ripper121/Keyboard/Pr0board_Lite/Firmware/Pr0Board_Led_Test/Button_Mapping.PNG

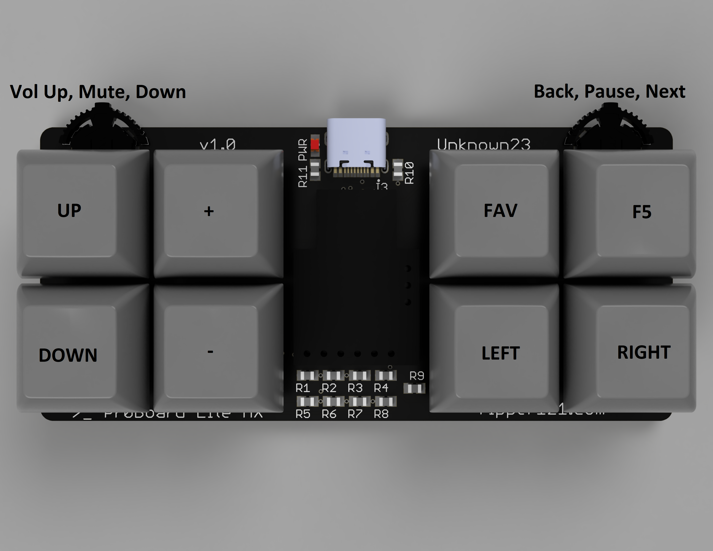
Pr0board_Lite/Firmware/Pr0Board_Led_Test/Button_Mapping.PNG
