ripper121/Keyboard/Pr0Board/Firmware/Bootloader/fuses.png

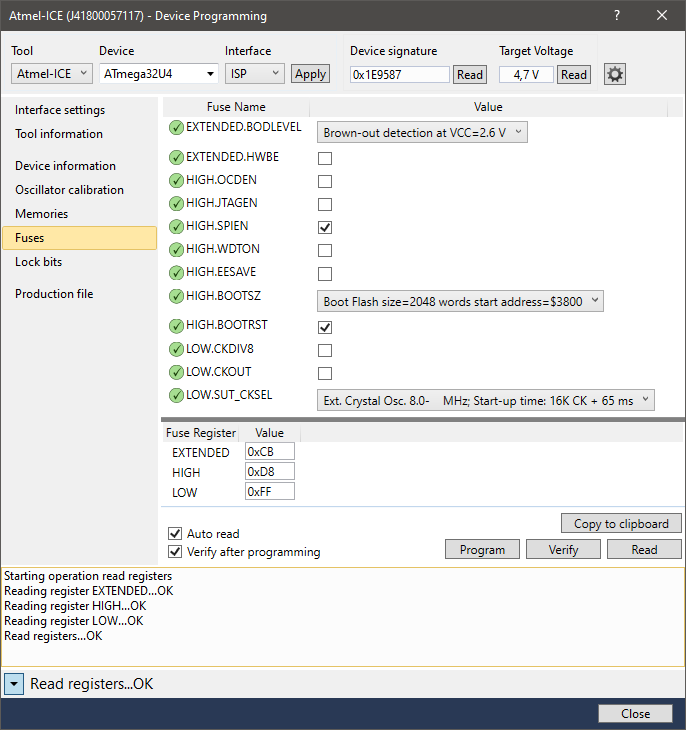
Pr0Board/Firmware/Bootloader/fuses.png
