ripper121/Keyboard/Pr0Board/Hardware/DickButt.jpg

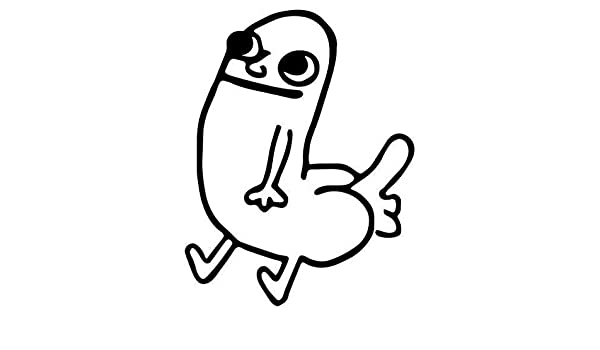
Pr0Board/Hardware/DickButt.jpg
