ripper121/Keyboard/Pr0board_Lite/Firmware/bootloader/fuses.png

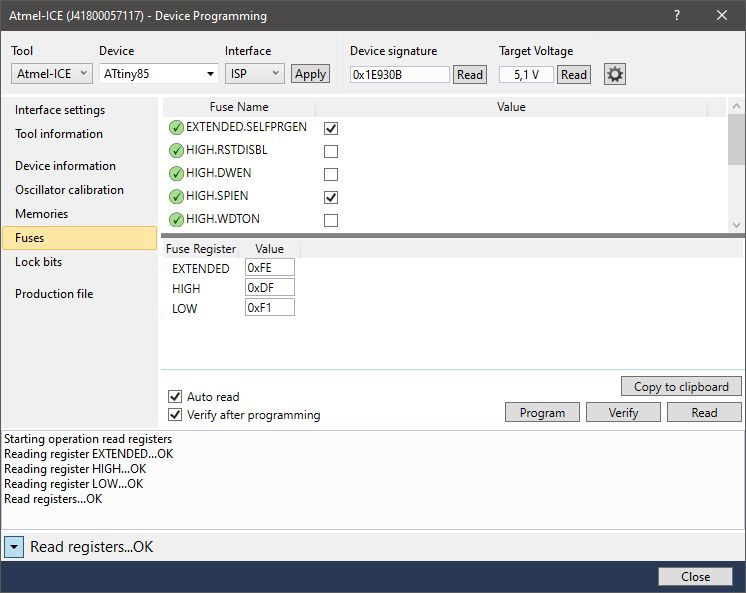
Pr0board_Lite/Firmware/bootloader/fuses.png
