ripper121/Keyboard/Pr0board_Lite/Hardware/render/9a6030ba-e6ec-4932-b883-8665d415793d.PNG

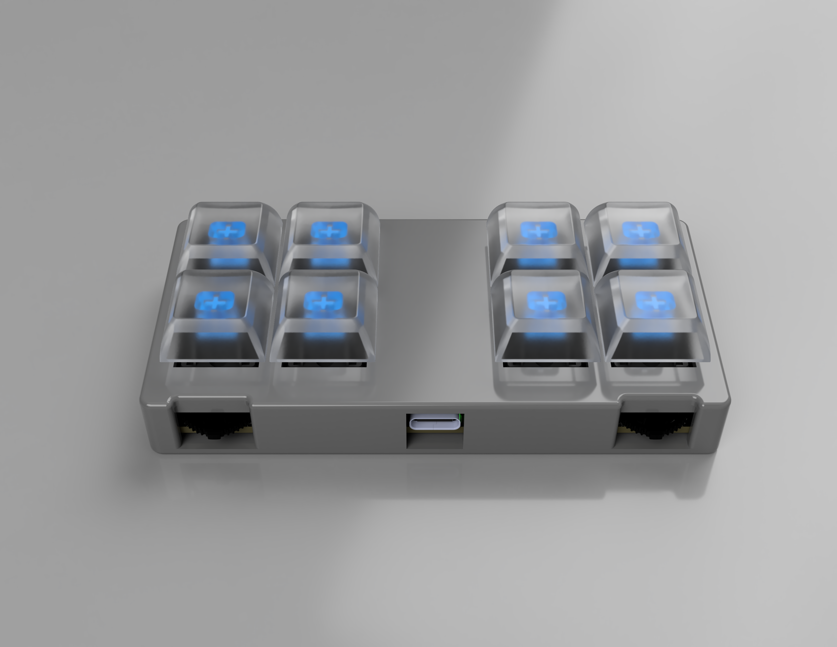
Pr0board_Lite/Hardware/render/9a6030ba-e6ec-4932-b883-8665d415793d.PNG
