ripper121/Keyboard/Pr0board_Lite/Hardware/render/63531ed1-c803-45b3-83f2-83a99b696628.PNG

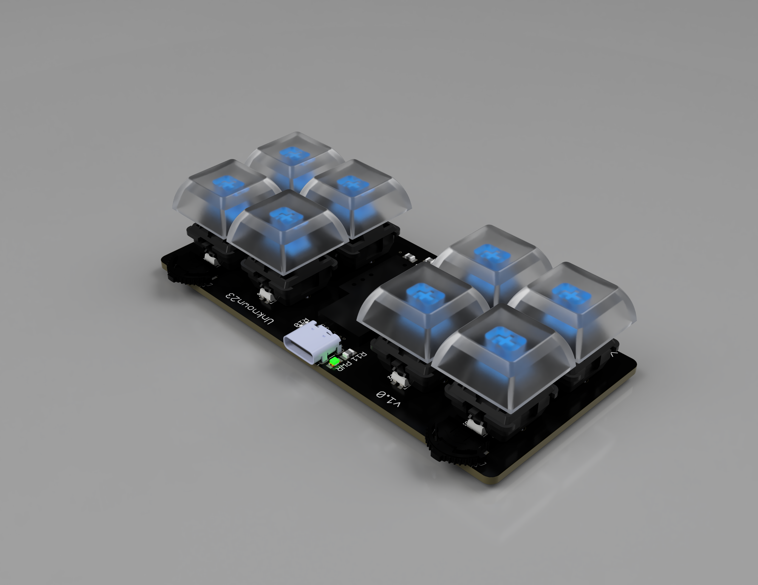
Pr0board_Lite/Hardware/render/63531ed1-c803-45b3-83f2-83a99b696628.PNG
