ripper121/Keyboard/Pr0board_Lite/Hardware/render/b3451999-1874-4866-8d40-73a651b3b092.PNG

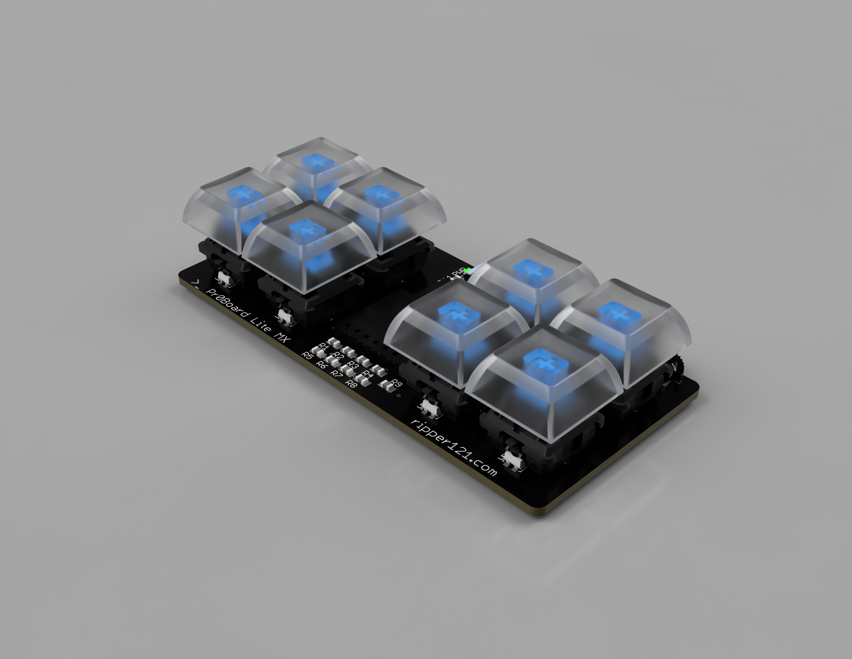
Pr0board_Lite/Hardware/render/b3451999-1874-4866-8d40-73a651b3b092.PNG
