ripper121/Keyboard/Pr0board_Lite/Hardware/render/Pr0board_Lite_MX_2021-May-11_08-17-31AM-000_CustomizedView18568659747.png

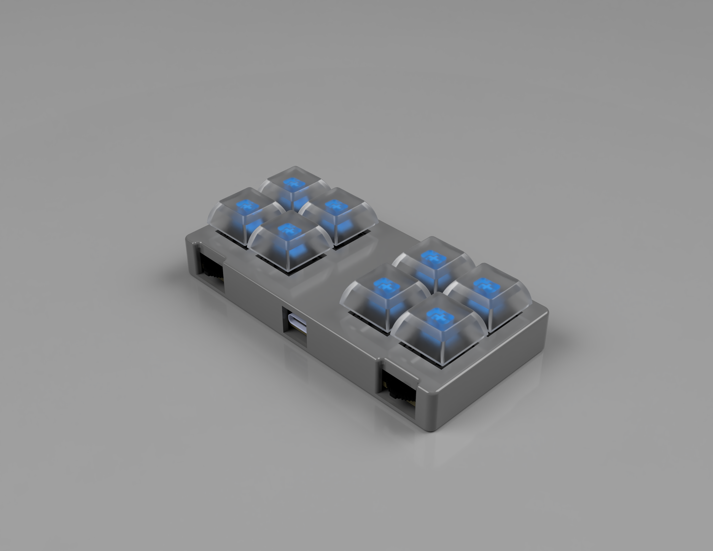
Pr0board_Lite/Hardware/render/Pr0board_Lite_MX_2021-May-11_08-17-31AM-000_CustomizedView18568659747.png
