ripper121/Keyboard/Pr0board_Lite/Hardware/render/Pr0board_Lite_MX_2021-May-11_08-21-41AM-000_CustomizedView15612525975.png

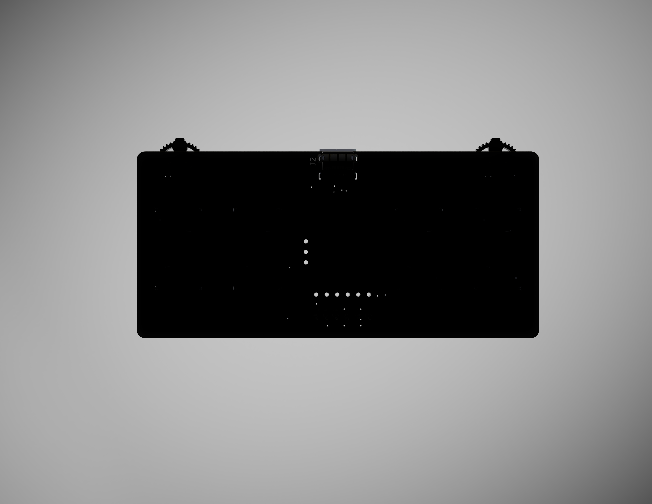
Pr0board_Lite/Hardware/render/Pr0board_Lite_MX_2021-May-11_08-21-41AM-000_CustomizedView15612525975.png
