ripper121/Keyboard/Pr0board_Lite/Hardware/render/Pr0board_Lite_MX_2021-May-11_08-22-08AM-000_CustomizedView36498695861.png

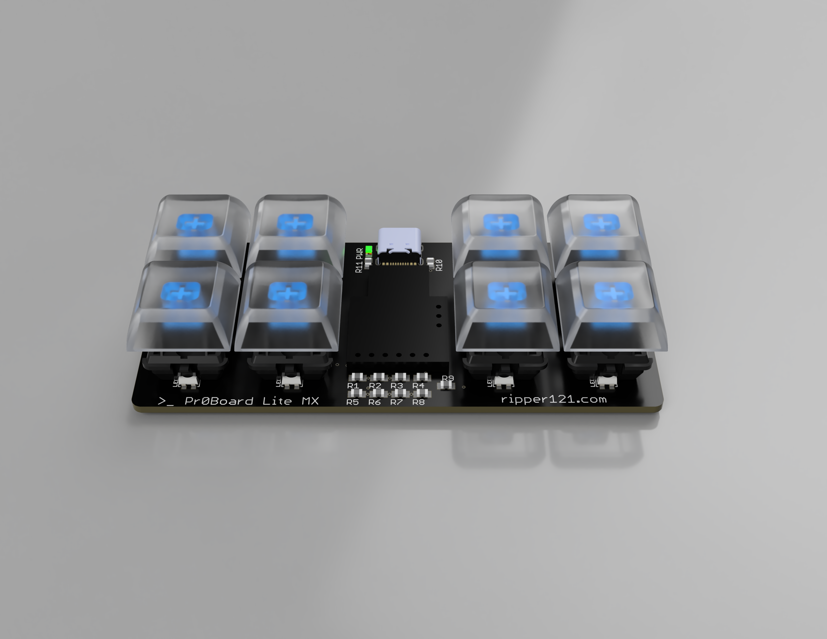
Pr0board_Lite/Hardware/render/Pr0board_Lite_MX_2021-May-11_08-22-08AM-000_CustomizedView36498695861.png
