ripper121/Keyboard/Pr0board_Lite/Hardware/eagle/3d/asm_mx_asm_PCB.stp

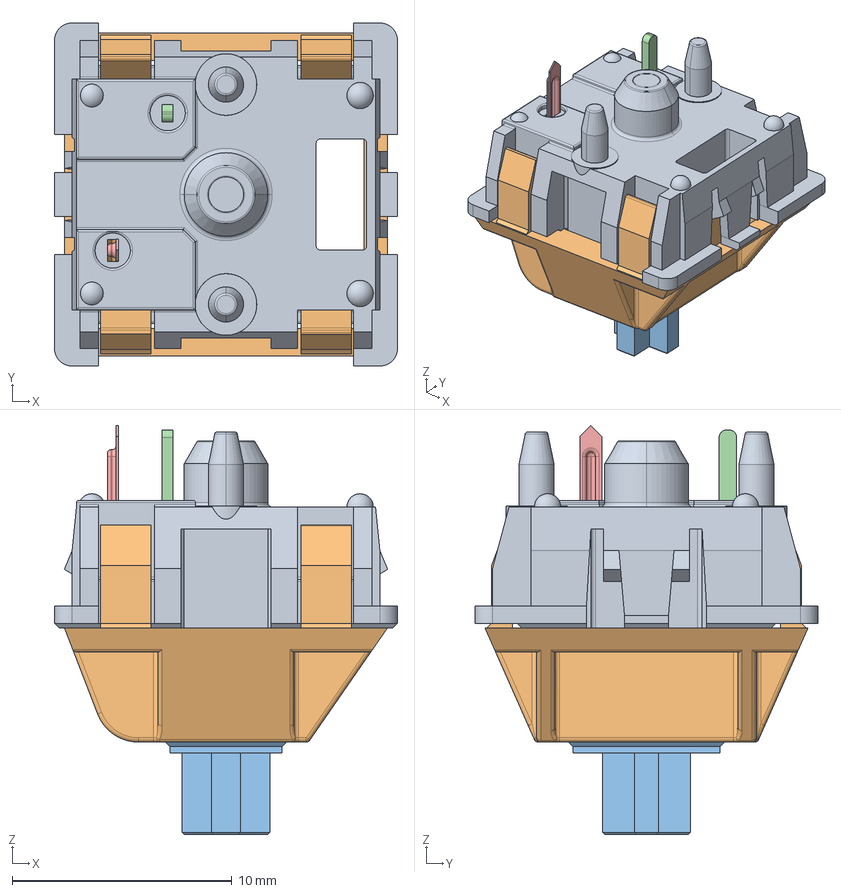
[picture p12: CAD file, 2021-05-19]
Pr0board_Lite/Hardware/eagle/3d/asm_mx_asm_PCB.stp
15.6 x 15.6 x 18.6 mm
MX_DOWN
MX_UP
UP_MX
MX_PIN
MX_SPRING
MX_CLICK
