ripper121/Keyboard/Pr0board_Lite/Hardware/3d/EnclosureTop.stl

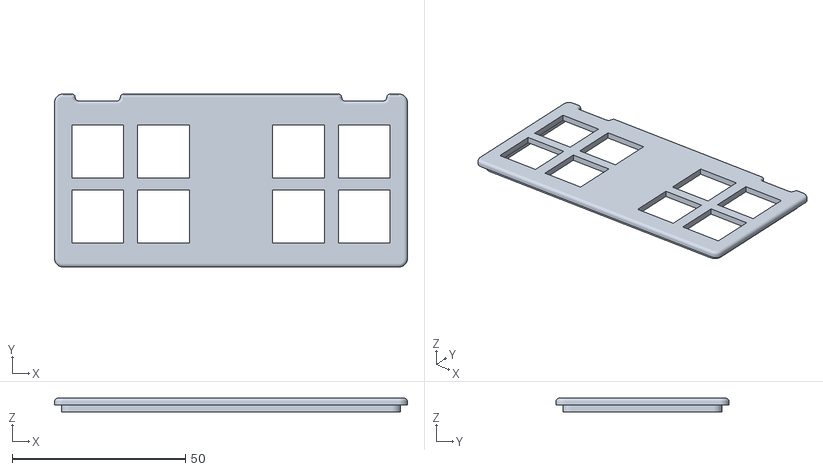
[picture p13: CAD file, 2021-05-19]
Pr0board_Lite/Hardware/3d/EnclosureTop.stl
102.0 x 50.0 x 4.00
