ripper121/Keyboard/Pr0board_Lite/Hardware/3d/EnclosureBottom.stl

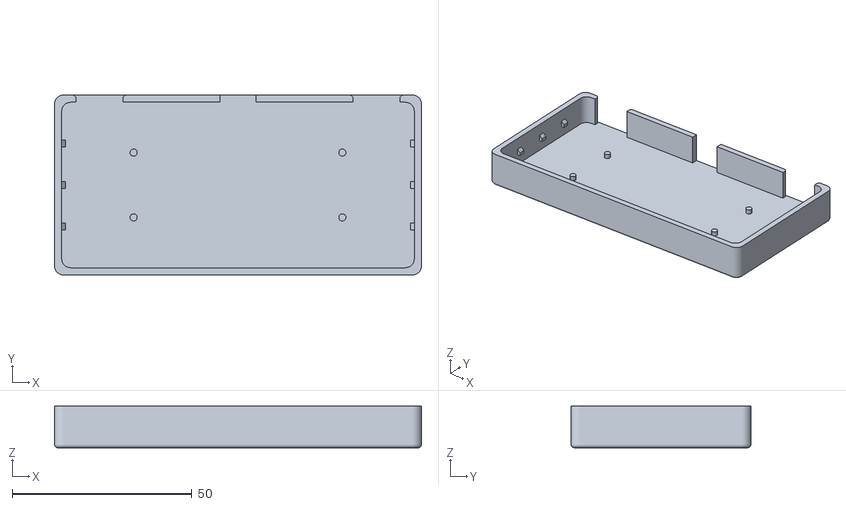
[picture p14: CAD file, 2021-05-19]
Pr0board_Lite/Hardware/3d/EnclosureBottom.stl
102.0 x 50.0 x 11.6
