ripper121/Keyboard/Pr0board_Lite/Hardware/eagle/3d/2-1437565-9.stp

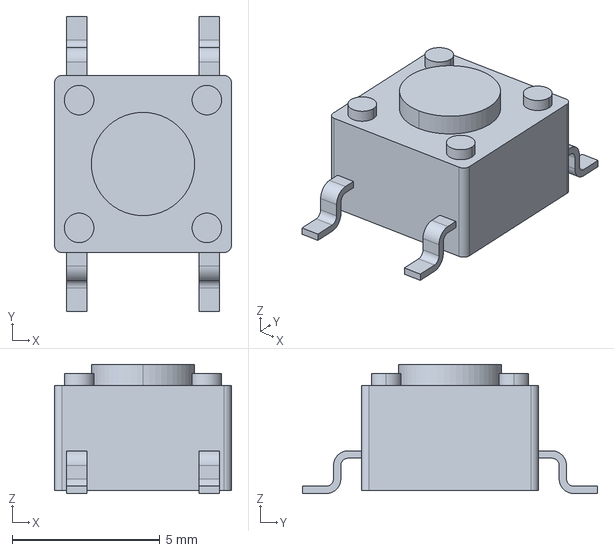
[picture p15: CAD file, 2021-05-19]
Pr0board_Lite/Hardware/eagle/3d/2-1437565-9.stp
6.00 x 10.0 x 4.38 mm
