ripper121/Keyboard/Pr0board_Lite/Hardware/eagle/3d/DigiSpark ATtiny85.STEP

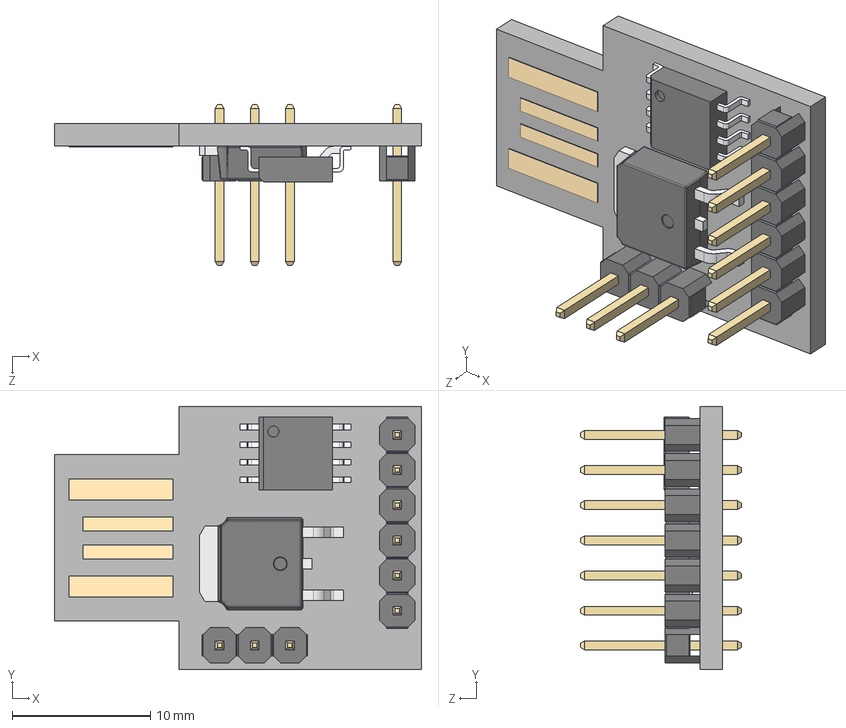
[picture p16: CAD file, 2021-05-19]
Pr0board_Lite/Hardware/eagle/3d/DigiSpark ATtiny85.STEP
26.5 x 19.0 x 11.6 mm
Digispark - Board simple
TO-252AA-IRF
8S2 EIAJ SOIC - ATtiny85 20SU_Valor predeterminado
DS1021-1x3SF11
DS1021-1x6SF11
