ripper121/Keyboard/Pr0board_Lite/Hardware/eagle/3d/TYPE-C-31-M-12--3DModel-STEP-56544.STEP

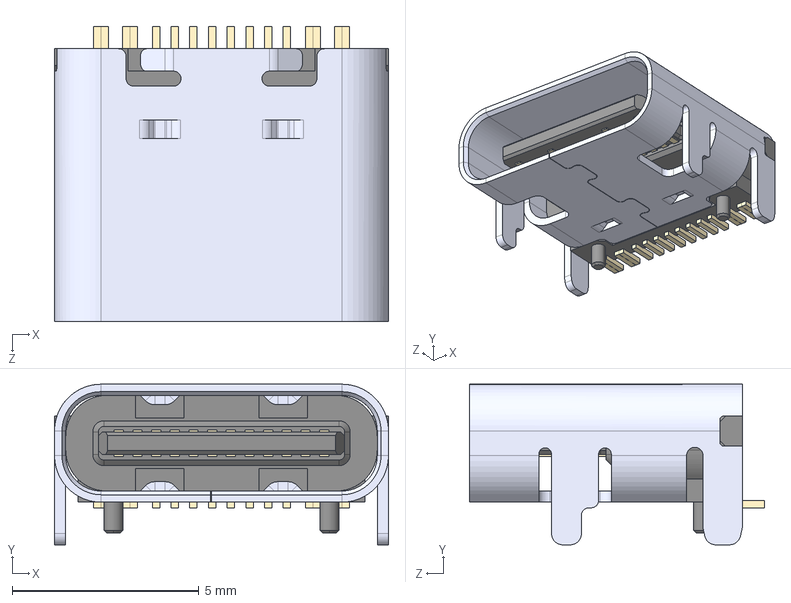
[picture p17: CAD file, 2021-05-19]
Pr0board_Lite/Hardware/eagle/3d/TYPE-C-31-M-12--3DModel-STEP-56544.STEP
8.94 x 4.30 x 7.90 mm
