ripper121/Keyboard/Pr0board_Lite/Hardware/eagle/3d/ts-1187a-x-g-x.stp

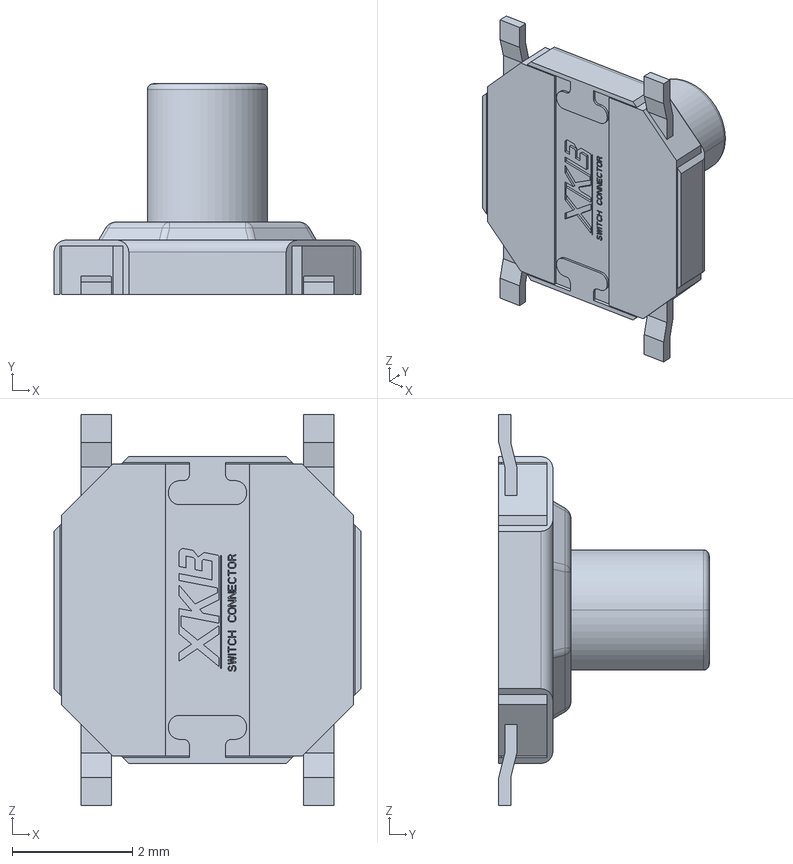
[picture p18: CAD file, 2021-05-19]
Pr0board_Lite/Hardware/eagle/3d/ts-1187a-x-g-x.stp
5.10 x 3.50 x 6.50 mm
