ripper121/Keyboard/Pr0board_Lite/Hardware/eagle/3d/1054500101--3DModel-STEP-56544.STEP

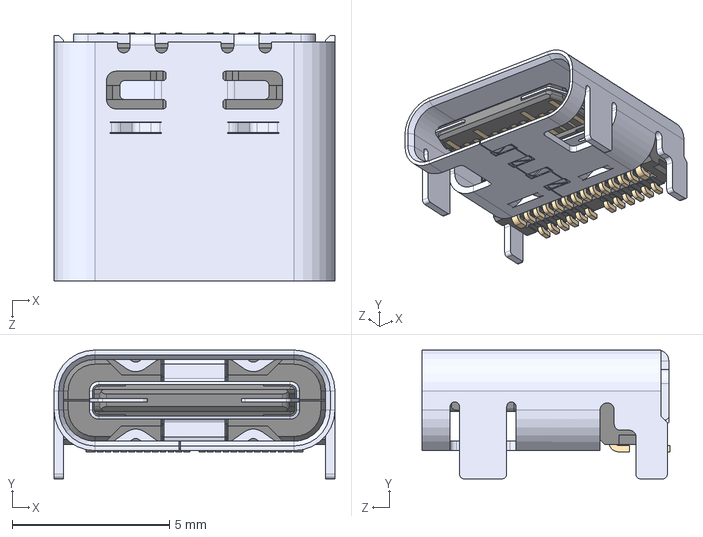
[picture p19: CAD file, 2021-05-19]
Pr0board_Lite/Hardware/eagle/3d/1054500101--3DModel-STEP-56544.STEP
8.94 x 4.10 x 7.90 mm
