ripper121/Keyboard/Pr0board_Lite/Hardware/eagle/3d/10118194-0001LF--3DModel-STEP-56544.STEP

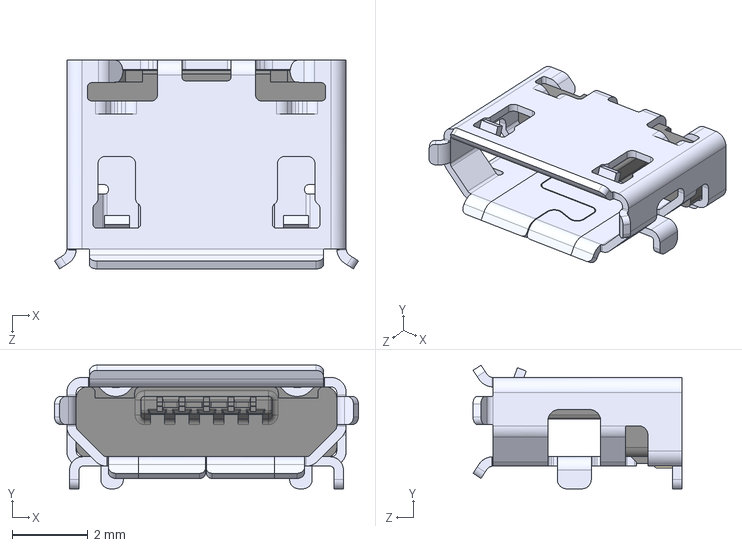
[picture p20: CAD file, 2021-05-19]
Pr0board_Lite/Hardware/eagle/3d/10118194-0001LF--3DModel-STEP-56544.STEP
8.05 x 3.27 x 5.53 mm
