ripper121/Keyboard/(list of files, cad)

Other CAD files:
Pr0board_Lite/Hardware/eagle/3d/Pr0board_Lite v5.f3z
