ripper121/Keyboard/Pr0Board/Hardware/pr0board_main.pdf

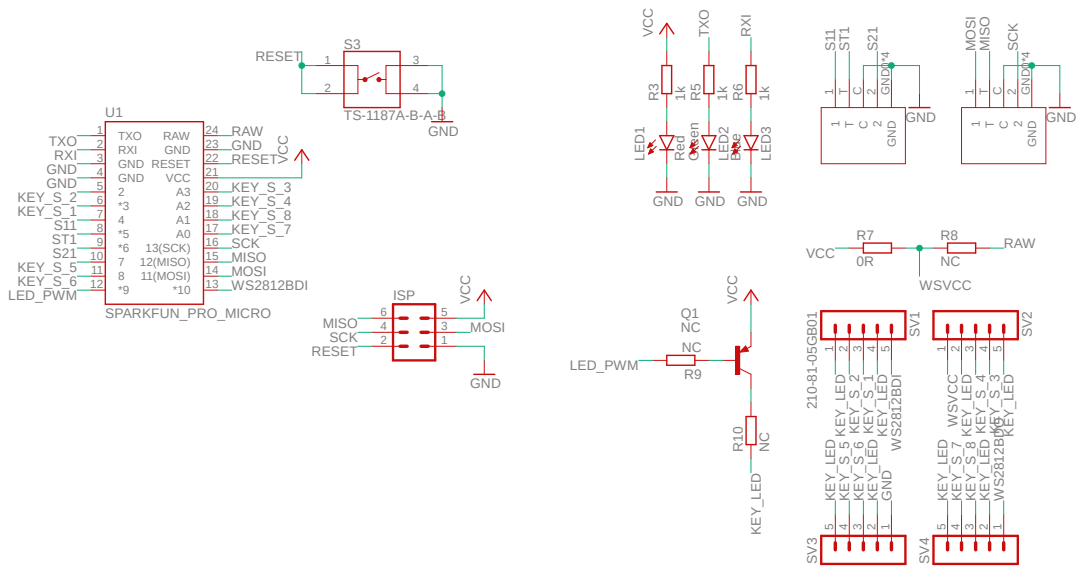
[picture p21: page 1]
Green Blue 1k1k; GND; GND 210⁻81⁻05GB⁰¹; TS-1187A-B-A-B GND VCC; VCC; NC Red 1k VCC; SPARKFUN_PRO_MICRO VCC; GND GND LED²; LED³ R⁵; T GND GND0*4; ISP; R¹⁰; R8 LED¹ R³; 13 11(MOSI); 14 12(MISO); 15 13(SCK); 20 GND 4; 23 RAW; GND 3; RESET; 22 RXI 2; TXO 1; S²¹; S¹¹ ST1; WSVCCWSVCC; MOSI; MISO; SCK; RAW; RAW WS²⁸¹²BDI; WS2812BDI; KEY_S_1; KEY_S_2; KEY_S_4; KEY_S_3; KEY_LED; KEY_LED KEY_LED; KEY_S_5; KEY_S_6; KEY_S_7; KEY_S_8; WS²⁸¹²BDO; TXO; RXI; LED_PWM
