ripper121/Keyboard/Pr0Board/Hardware/pr0board_key.pdf

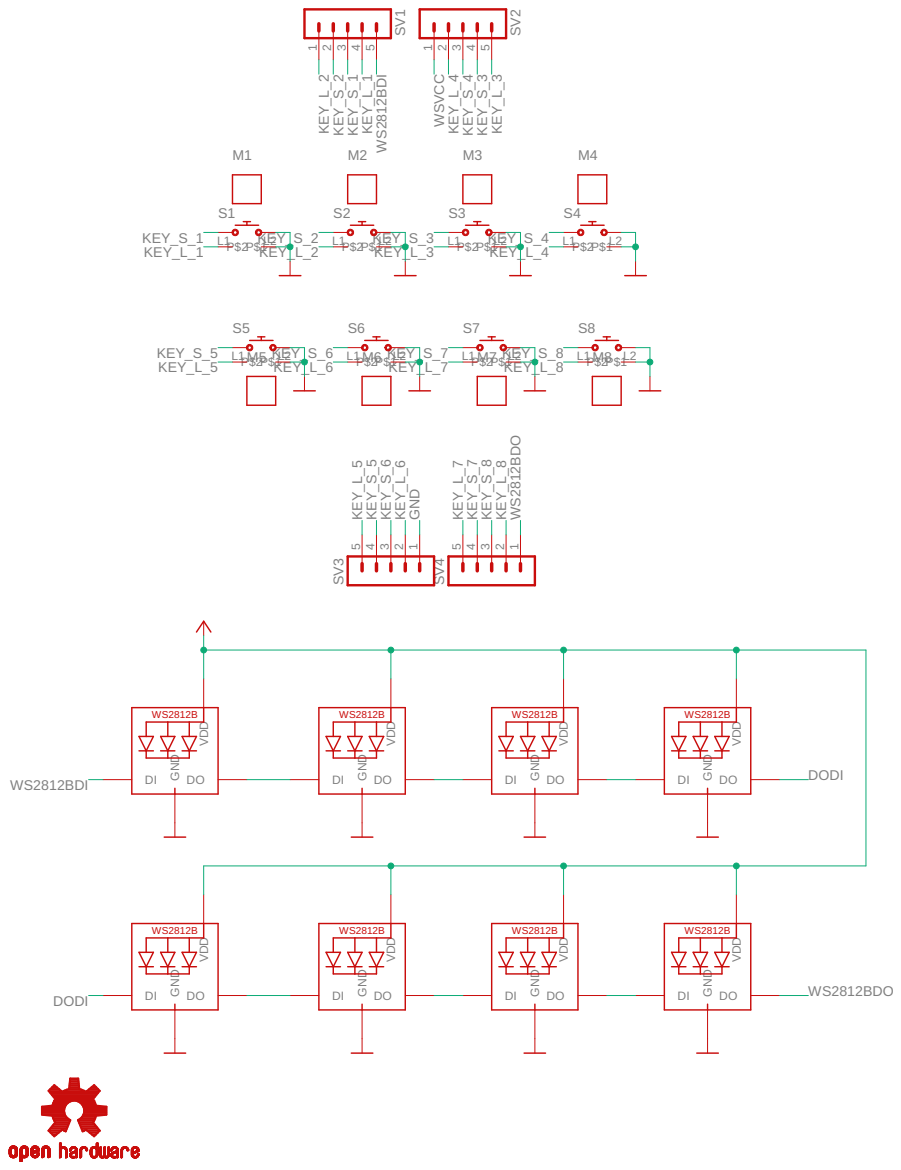
[picture p22: page 1]
