ripper121/Keyboard/Pr0board_Lite/Hardware/eagle/Pr0board_Lite_Main.brd

## EAGLE design Pr0board_Lite/Hardware/eagle/Pr0board_Lite_Main.brd (2021-09-08)

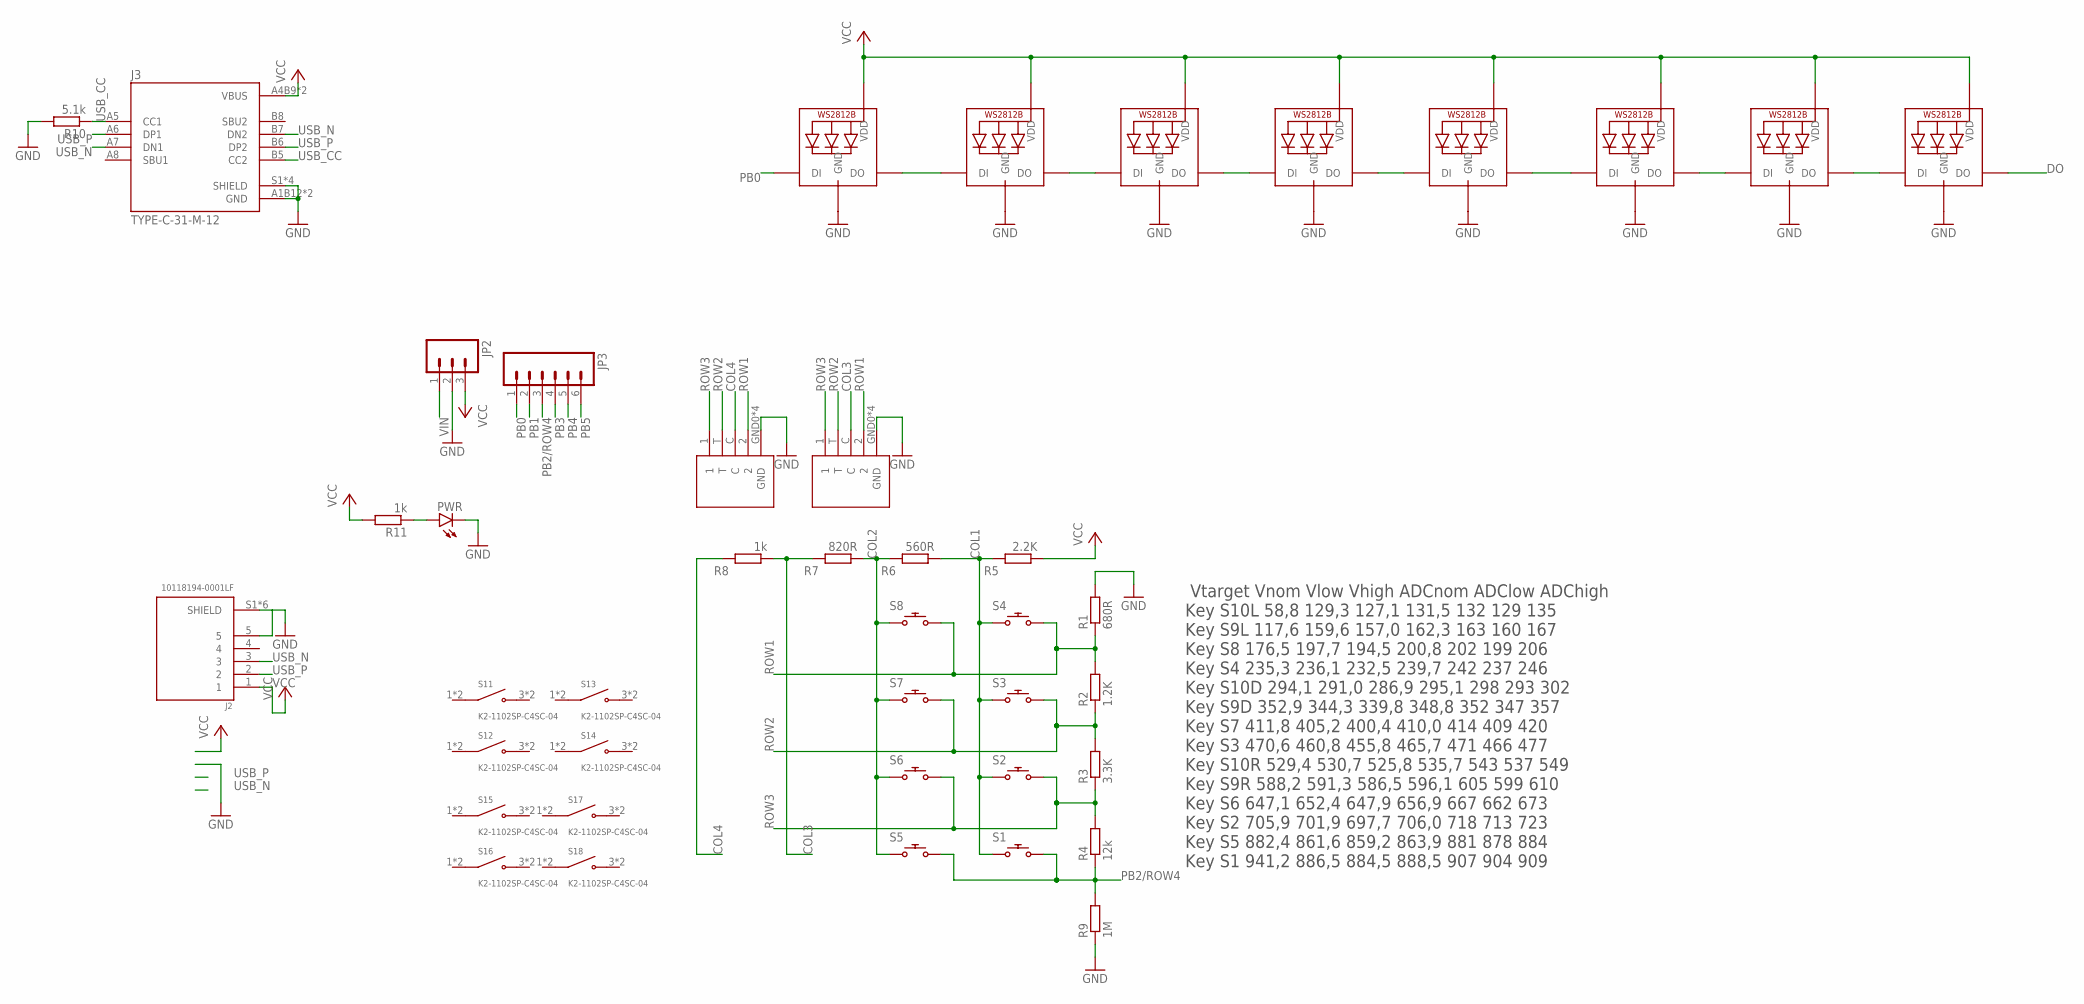
[picture p23: schematic Pr0board_Lite_Main.sch]

Parts:
J2: 10118194-0001LF; AMPHENOL_10118194-0001LF
J3: TYPE-C-31-M-12; HRO_TYPE-C-31-M-12
JP2: M03PTH; 1X03
JP3: M06SIP; 1X06
LED1, LED2, LED3, LED4, LED5, LED6, LED7, LED8: WS2812B3535; LED3535
PWR: LEDCHIP-LED0805; CHIP-LED0805
R1: 680R; R0805
R2: 1.2K; R0805
R3: 3.3K; R0805
R4: 12k; R0805
R5: 2.2K; R0805
R6: 560R; R0805
R7: 820R; R0805
R8, R11: 1k; R0805
R9: 1M; R0805
R10: 5.1k; R0805
S1, S2, S3, S4, S5, S6, S7, S8: CPG151101S13 C404353; CHERRY_MX_LED
S9, S10: TM-2024A
S11, S12, S13, S14, S15, S16, S17, S18: K2-1102SP-C4SC-04; SW_2-1437565-9

Connections:
COL1: R5.2, R6.1, S1.S1 (1), S2.S1 (1), S3.S1 (1), S4.S1 (1)
COL2: R6.2, R7.1, S5.S1 (1), S6.S1 (1), S7.S1 (1), S8.S1 (1)
COL3: R7.2, R8.1, S9.C
COL4: R8.2, S10.C
DO: LED7.2 (DO)
GND: J2.5, J2.S1 (SHIELD), J2.S2 (SHIELD), J2.S3 (SHIELD), J2.S4 (SHIELD), J2.S5 (SHIELD), J2.S6 (SHIELD), J3.A1B12 (GND), J3.B1A12 (GND), J3.S1 (SHIELD), J3.S2 (SHIELD), J3.S3 (SHIELD), J3.S4 (SHIELD), JP2.2, LED1.3 (GND), LED2.3 (GND), LED3.3 (GND), LED4.3 (GND), LED5.3 (GND), LED6.3 (GND), LED7.3 (GND), LED8.3 (GND), PWR.C, R1.2, R9.1, R10.2, S9.GND0 (GND), S9.GND1 (GND), S9.GND2 (GND), S9.GND3 (GND), S10.GND0 (GND), S10.GND1 (GND), S10.GND2 (GND), S10.GND3 (GND)
unnamed: LED1.2 (DO), LED3.4 (DI)
unnamed: LED4.2 (DO), LED5.4 (DI)
unnamed: LED1.4 (DI), LED2.2 (DO)
unnamed: LED3.2 (DO), LED4.4 (DI)
unnamed: PWR.A, R11.1
unnamed: LED5.2 (DO), LED6.4 (DI)
unnamed: LED6.2 (DO), LED8.4 (DI)
unnamed: LED7.4 (DI), LED8.2 (DO)
PB0: JP3.1, LED2.4 (DI)
PB1: JP3.2
PB2/ROW4: JP3.3, R4.1, R9.2, S1.S2 (2), S5.S2 (2)
PB3: JP3.4
PB4: JP3.5
PB5: JP3.6
ROW1: R1.1, R2.2, S4.S2 (2), S8.S2 (2), S9.2, S10.2
ROW2: R2.1, R3.2, S3.S2 (2), S7.S2 (2), S9.T, S10.T
ROW3: R3.1, R4.2, S2.S2 (2), S6.S2 (2), S9.1, S10.1
USB_CC: J3.A5 (CC1), J3.B5 (CC2), R10.1
USB_N: J2.3, J3.A7 (DN1), J3.B7 (DN2)
USB_P: J2.2, J3.A6 (DP1), J3.B6 (DP2)
VCC: J2.1, J3.A4B9 (VBUS), J3.B4A9 (VBUS), JP2.3, LED1.1 (VDD), LED2.1 (VDD), LED3.1 (VDD), LED4.1 (VDD), LED5.1 (VDD), LED6.1 (VDD), LED7.1 (VDD), LED8.1 (VDD), R5.1, R11.2
VIN: JP2.1

Notes on the sheet:
Vtarget Vnom Vlow Vhigh ADCnom ADClow ADChigh Key S10L 58,8 129,3 127,1 131,5 132 129 135 Key S9L 117,6 159,6 157,0 162,3 163 160 167 Key S8 176,5 197,7 194,5 200,8 202 199 206 Key S4 235,3 236,1 232,5 239,7 242 237 246 Key S10D 294,1 291,0 286,9 295,1 298 293 302 Key S9D 352,9 344,3 339,8 348,8 35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

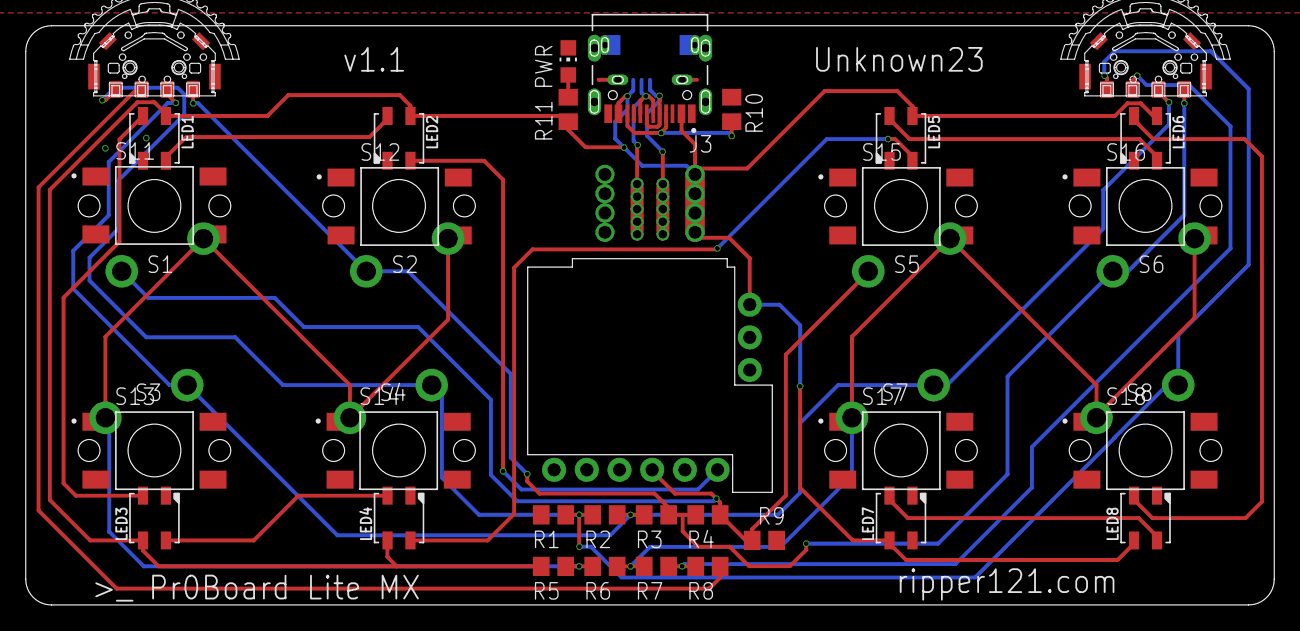
[picture p24: board Pr0board_Lite_Main.brd from above]

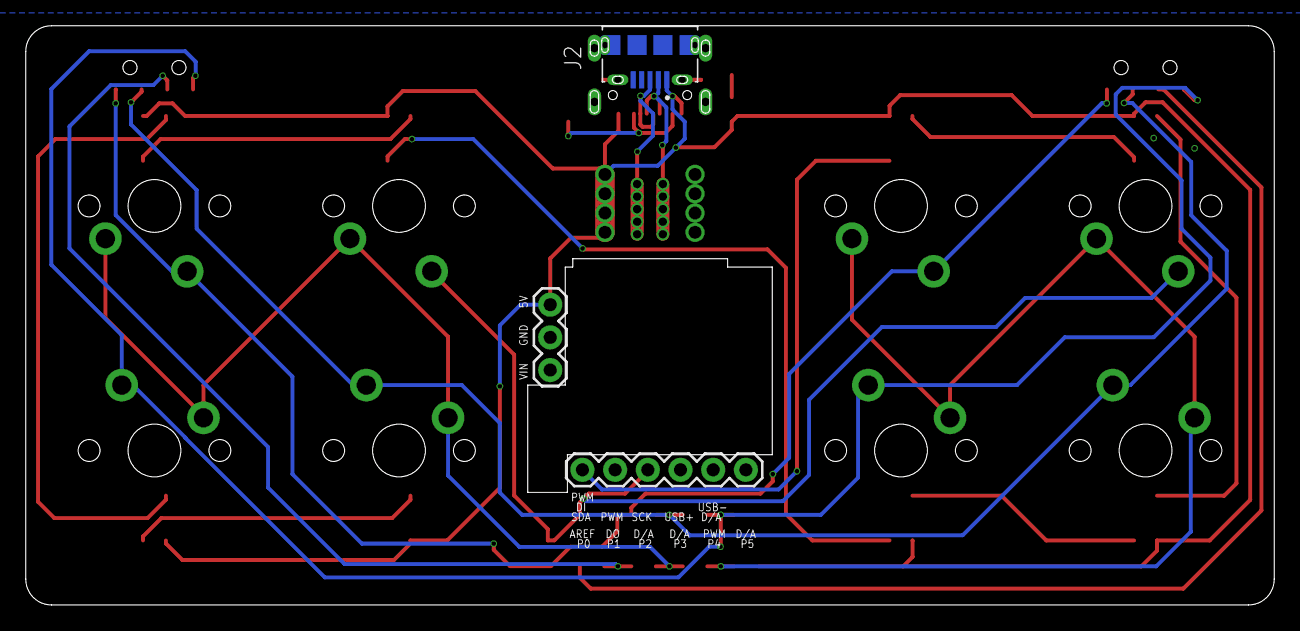
[picture p25: board Pr0board_Lite_Main.brd from below]

Board: 2 copper layers, 97.0 x 45.0 mm, 42 parts (3 on the bottom side), 22 nets.
