ripper121/Keyboard/Pr0board_Lite/Hardware/eagle/digispark/DIGISPARK_PRODUCTION_REV3.brd

## EAGLE design Pr0board_Lite/Hardware/eagle/digispark/DIGISPARK_PRODUCTION_REV3.brd (2021-05-19)

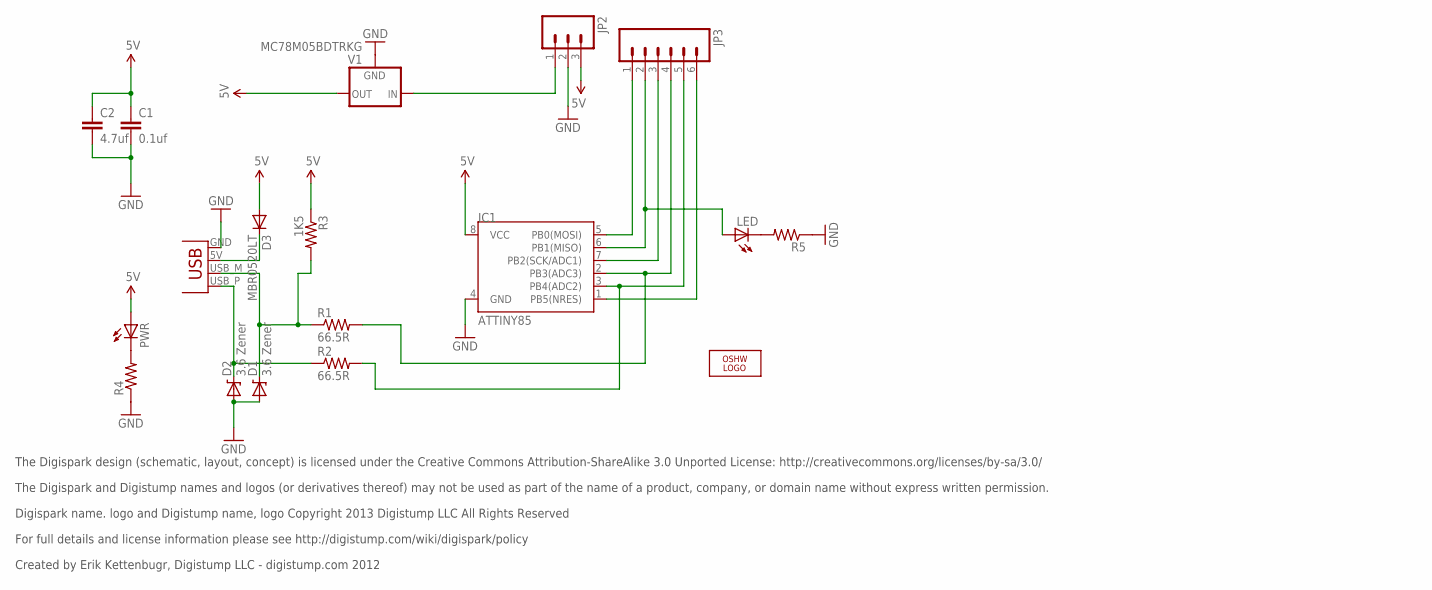
[picture p26: schematic DIGISPARK_PRODUCTION_REV3.sch]

Parts:
C1: 0.1uf; 0402-CAP
C2: 4.7uf; 0805
D1, D2: 3.6 Zener; SOD-323
D3: MBR0520LT; SOD123
IC1: ATTINY85; SO08-EIAJ
JP2: M03PTH; 1X03
JP3: M06SIP; 1X06
LED: LED0603; LED-0603
LOGO2: LOGO-OSHW-10MILX0200-NT; OSHW_10X200_NOTEXT
PWR: LED0603; LED-0603
R1, R2: 66.5R; 0402-RES
R3: 1K5; 0402-RES
R4, R5: RESISTOR0402-RES; 0402-RES
V1: MC78M05BDTRKG; DPACK
X1: USBPCB; USB-A-PCB

Connections:
5V: C1.1, C2.1, D3.A, IC1.8 (VCC), JP2.3, PWR.A, R3.1, V1.3 (OUT)
GND: C1.2, C2.2, D1.2 (A), D2.2 (A), IC1.4 (GND), JP2.2, R4.1, R5.1, V1.4 (GND), X1.GND
unnamed: IC1.2 (PB3(ADC3)), JP3.4, R1.2
unnamed: IC1.6 (PB1(MISO)), JP3.2, LED.A
unnamed: IC1.5 (PB0(MOSI)), JP3.1
unnamed: IC1.7 (PB2(SCK/ADC1)), JP3.3
unnamed: IC1.3 (PB4(ADC2)), JP3.5, R2.2
unnamed: IC1.1 (PB5(NRES)), JP3.6
unnamed: D1.1 (C), R1.1, R3.2, X1.USB_M (D-)
unnamed: D2.1 (C), R2.1, X1.USB_P (D+)
unnamed: LED.C, R5.2
unnamed: JP2.1, V1.1 (IN)
unnamed: D3.C, X1.5V (VBUS)
unnamed: PWR.C, R4.2

Notes on the sheet:
The Digispark design (schematic, layout, concept) is licensed under the Creative Commons Attribution-ShareAlike 3.0 Unported License: http://creativecommons.org/licenses/by-sa/3.0/
The Digispark and Digistump names and logos (or derivatives thereof) may not be used as part of the name of a product, company, or domain name without express written permission.
Digispark name. logo and Digistump name, logo Copyright 2013 Digistump LLC All Rights Reserved
For full details and license information please see http://digistump.com/wiki/digispark/policy
Created by Erik Kettenbugr, Digistump LLC - digistump.com 2012

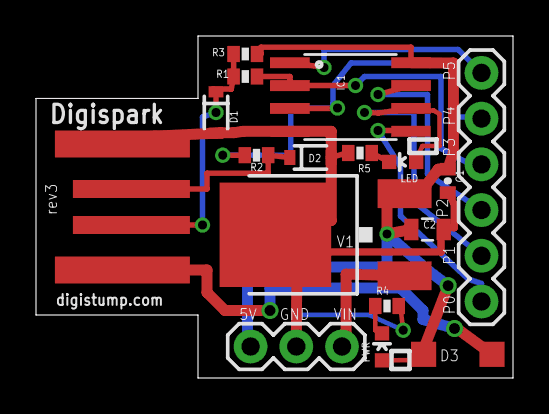
[picture p27: board DIGISPARK_PRODUCTION_REV3.brd from above]

Board: 2 copper layers, 26.5 x 19.0 mm, 18 parts (1 on the bottom side), 14 nets.
