ripper121/Keyboard/Pr0Board/Hardware/pr0board_main.brd

## EAGLE design Pr0Board/Hardware/pr0board_main.brd (2021-05-19)

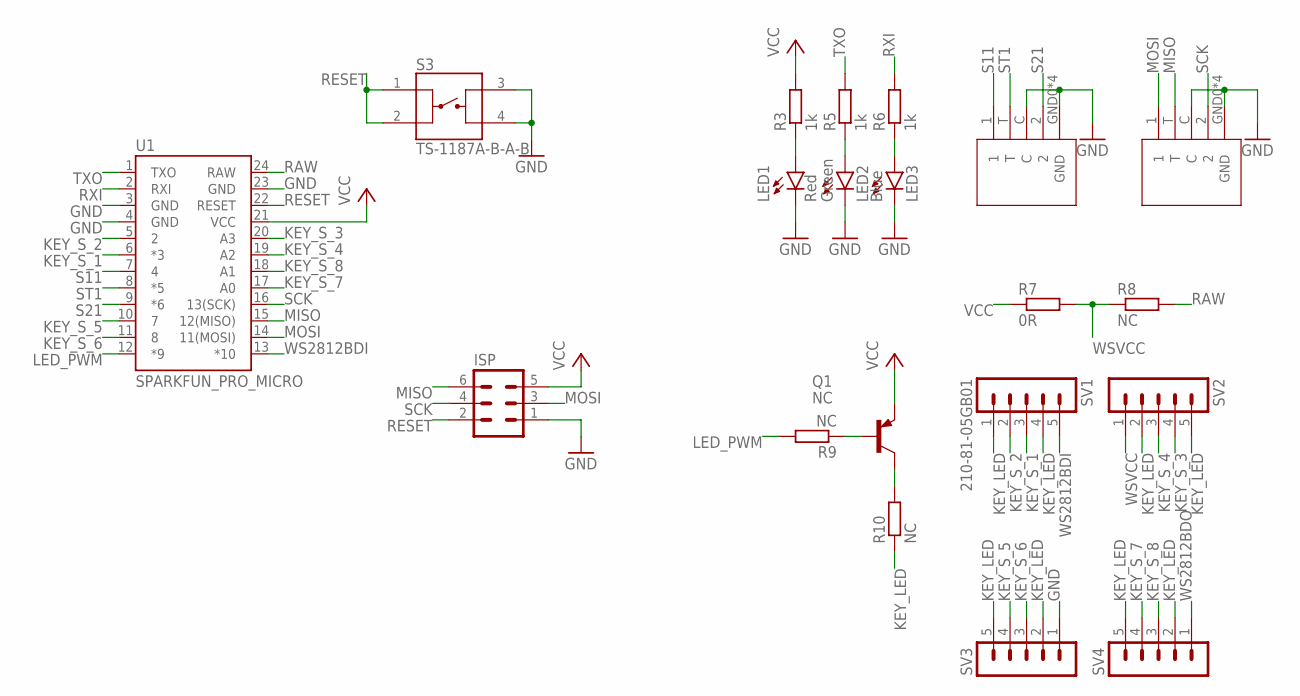
[picture p28: schematic pr0board_main.sch]

Parts:
ISP: MA03-2
LED1: Red; CHIP-LED0603
LED2: Green; CHIP-LED0603
LED3: Blue; CHIP-LED0603
Q1: NC; SOT23
R3, R5, R6: 1k; R0603
R7: 0R; R0603
R8, R9: NC; R0603
R10: NC; R0805
S1, S2: TM-2024A
S3: TS-1187A-B-A-B; SW_PTS525SM15SMTR2LFS
SV1: 210-81-05GB01; MA05-1
SV2, SV3, SV4: MA05-1
U1: SPARKFUN_PRO_MICRO

Connections:
GND: ISP.1, LED1.C, LED2.C, LED3.C, S1.C, S1.GND0 (GND), S1.GND1 (GND), S1.GND2 (GND), S1.GND3 (GND), S2.C, S2.GND0 (GND), S2.GND1 (GND), S2.GND2 (GND), S2.GND3 (GND), S3.3, S3.4, SV3.1, U1.3 (GND), U1.4 (GND), U1.23 (GND)
KEY_LED: R10.1, SV1.1, SV1.4, SV2.2, SV2.5, SV3.2, SV3.5, SV4.2, SV4.5
KEY_S_1: SV1.3, U1.6 (*3)
KEY_S_2: SV1.2, U1.5 (2)
KEY_S_3: SV2.4, U1.20 (A3)
KEY_S_4: SV2.3, U1.19 (A2)
KEY_S_5: SV3.4, U1.10 (7)
KEY_S_6: SV3.3, U1.11 (8)
KEY_S_7: SV4.4, U1.17 (A0)
KEY_S_8: SV4.3, U1.18 (A1)
LED_PWM: R9.2, U1.12 (*9)
MISO: ISP.6, S2.T, U1.15 (12(MISO))
MOSI: ISP.3, S2.1, U1.14 (11(MOSI))
unnamed: LED2.A, R5.1
unnamed: LED3.A, R6.1
unnamed: LED1.A, R3.1
unnamed: Q1.1 (B), R9.1
unnamed: Q1.3 (C), R10.2
RAW: R8.2, U1.24 (RAW)
RESET: ISP.2, S3.1, S3.2, U1.22 (RESET)
RXI: R6.2, U1.2 (RXI)
S11: S1.1, U1.7 (4)
S21: S1.2, U1.9 (*6)
SCK: ISP.4, S2.2, U1.16 (13(SCK))
ST1: S1.T, U1.8 (*5)
TXO: R5.2, U1.1 (TXO)
VCC: ISP.5, Q1.2 (E), R3.2, R7.1, U1.21 (VCC)
WS2812BDI: SV1.5, U1.13 (*10)
WS2812BDO: SV4.1
WSVCC: R7.2, R8.1, SV2.1

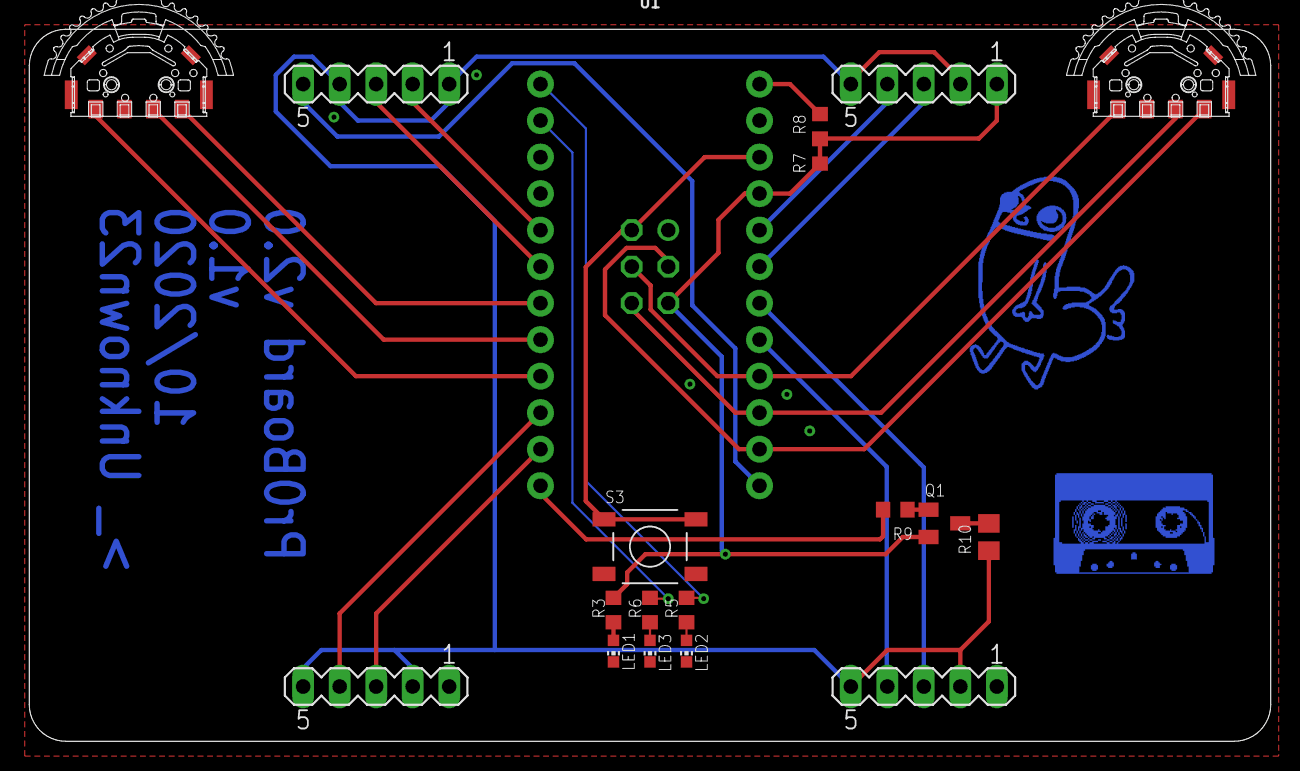
[picture p29: board pr0board_main.brd from above]

Board: 2 copper layers, 86.4 x 49.5 mm, 20 parts (1 on the bottom side), 29 nets.
