ripper121/Keyboard/Pr0Board/Hardware/pr0board_key.brd

## EAGLE design Pr0Board/Hardware/pr0board_key.brd (2021-05-19)

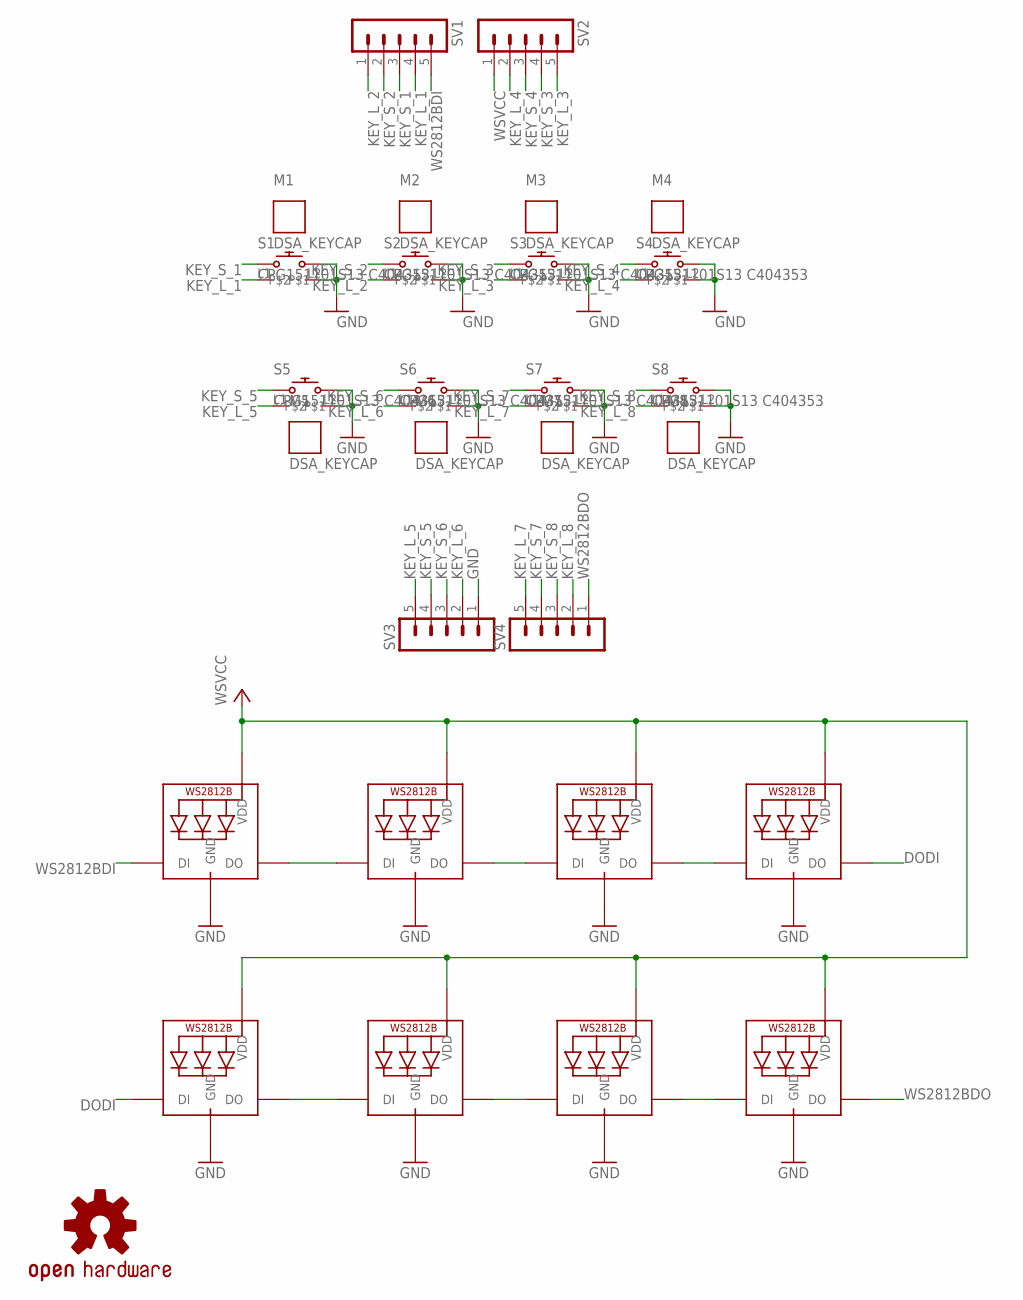
[picture p30: schematic pr0board_key.sch]

Parts:
LED1, LED2, LED3, LED4, LED5, LED6, LED7, LED8: WS2812B3535; LED3535
M1, M2, M3, M4, M5, M6, M7, M8: DSA_KEYCAP
S1, S2, S3, S4, S5, S6, S7, S8: CPG151101S13 C404353; CHERRY_MX_LED
SV1, SV2, SV3, SV4: MA05-1
U$1: OSHW-LOGOS; OSHW-LOGO-S

Connections:
DODI: LED4.2 (DO), LED5.4 (DI)
GND: LED1.3 (GND), LED2.3 (GND), LED3.3 (GND), LED4.3 (GND), LED5.3 (GND), LED6.3 (GND), LED7.3 (GND), LED8.3 (GND), S1.L2, S1.S2 (2), S2.L2, S2.S2 (2), S3.L2, S3.S2 (2), S4.L2, S4.S2 (2), S5.L2, S5.S2 (2), S6.L2, S6.S2 (2), S7.L2, S7.S2 (2), S8.L2, S8.S2 (2), SV3.1
KEY_L_1: S1.L1, SV1.4
KEY_L_2: S2.L1, SV1.1
KEY_L_3: S3.L1, SV2.5
KEY_L_4: S4.L1, SV2.2
KEY_L_5: S5.L1, SV3.5
KEY_L_6: S6.L1, SV3.2
KEY_L_7: S7.L1, SV4.5
KEY_L_8: S8.L1, SV4.2
KEY_S_1: S1.S1 (1), SV1.3
KEY_S_2: S2.S1 (1), SV1.2
KEY_S_3: S3.S1 (1), SV2.4
KEY_S_4: S4.S1 (1), SV2.3
KEY_S_5: S5.S1 (1), SV3.4
KEY_S_6: S6.S1 (1), SV3.3
KEY_S_7: S7.S1 (1), SV4.4
KEY_S_8: S8.S1 (1), SV4.3
unnamed: LED1.2 (DO), LED2.4 (DI)
unnamed: LED2.2 (DO), LED3.4 (DI)
unnamed: LED3.2 (DO), LED4.4 (DI)
unnamed: LED5.2 (DO), LED6.4 (DI)
unnamed: LED6.2 (DO), LED7.4 (DI)
unnamed: LED7.2 (DO), LED8.4 (DI)
WS2812BDI: LED1.4 (DI), SV1.5
WS2812BDO: LED8.2 (DO), SV4.1
WSVCC: LED1.1 (VDD), LED2.1 (VDD), LED3.1 (VDD), LED4.1 (VDD), LED5.1 (VDD), LED6.1 (VDD), LED7.1 (VDD), LED8.1 (VDD), SV2.1

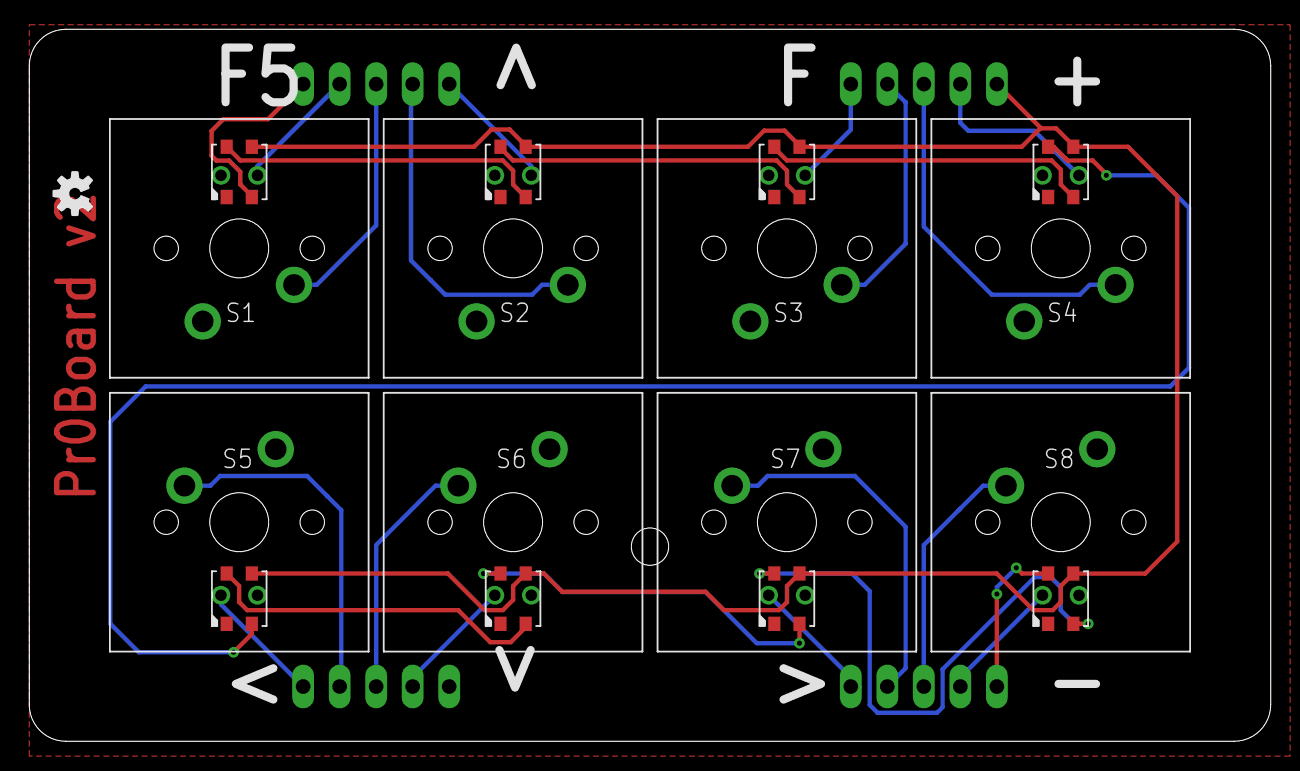
[picture p31: board pr0board_key.brd from above]

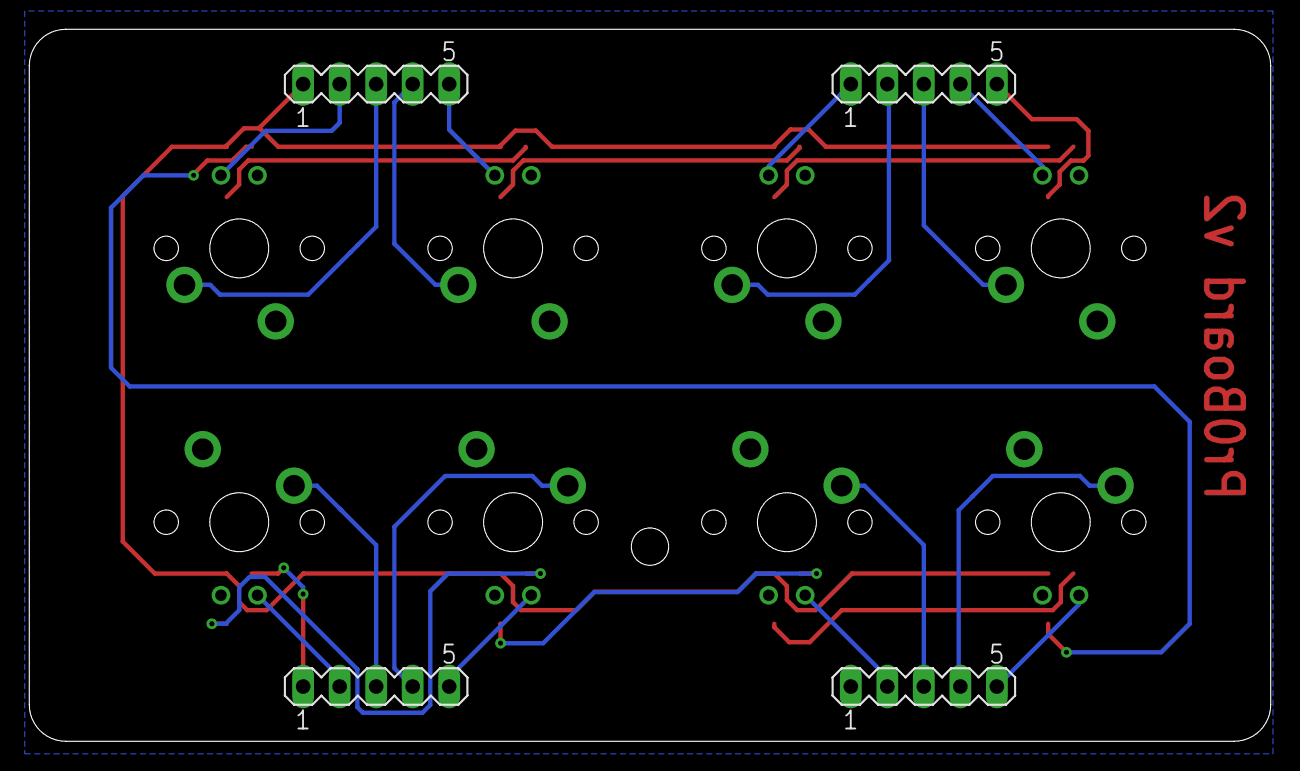
[picture p32: board pr0board_key.brd from below]

Board: 2 copper layers, 86.4 x 49.5 mm, 29 parts (4 on the bottom side), 27 nets.
