ripper121/Keyboard/(commit log)

2021-05-19 3D Files + Render
    [EnclosureBottom.stl, EnclosureTop.stl]
2021-09-08 fw & bootloader
    [Pr0board_Lite_Main.brd]
