ripper121/Keyboard/(notices)

Notices in the files:
Pr0board_Lite/Hardware/eagle/digispark/DIGISPARK_PRODUCTION_REV3.brd:
CC BY-SA 3.0
parts and their libraries:
SparkFun: Licensing: CC v3.0 Share-Alike You are welcome to use this library for commercial purposes.
SparkFun-Boards: Licensing: Creative Commons ShareAlike 4.0 International - https://creativecommons.org/licenses/by-sa/4.0
